BalafiaMaker/CANSAT24_SPACEMCQUEEN/imagenes/vista_ tinkercad_ve.jpg

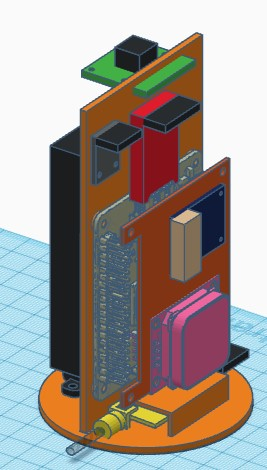
imagenes/vista_ tinkercad_ve.jpg
