BalafiaMaker/CANSAT24_SPACEMCQUEEN/README.md

# CANSAT24_SPACEMCQUEEN
Material per poder construir el CanSat
🧑‍🏭
Captura_de_pantalla_2024-04-27_164813-removebg-preview
