BalafiaMaker/CANSAT24_SPACEMCQUEEN/carcasa/V3_SMcQueen_cansat interior.stl

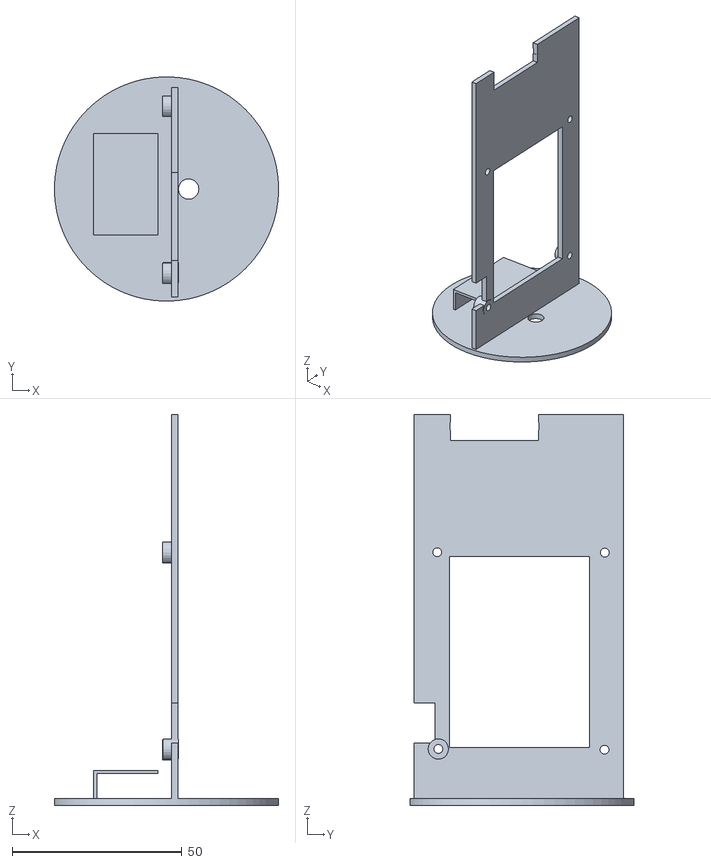
[picture p32: CAD file, 2024-04-27]
carcasa/V3_SMcQueen_cansat interior.stl
66.0 x 66.0 x 115.1
