BalafiaMaker/CANSAT24_SPACEMCQUEEN/carcasa/v3_SMcQueen_cansat exteriorA.stl

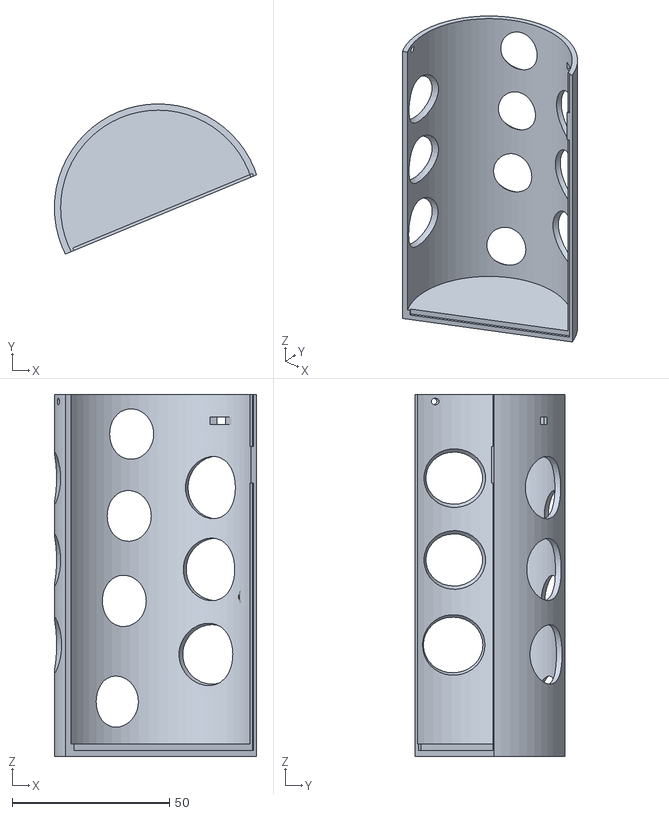
[picture p33: CAD file, 2024-04-27]
carcasa/v3_SMcQueen_cansat exteriorA.stl
64.3 x 47.7 x 115.0
