BalafiaMaker/CANSAT24_SPACEMCQUEEN/carcasa/v3_SMcQueen_cansat exteriorB.stl

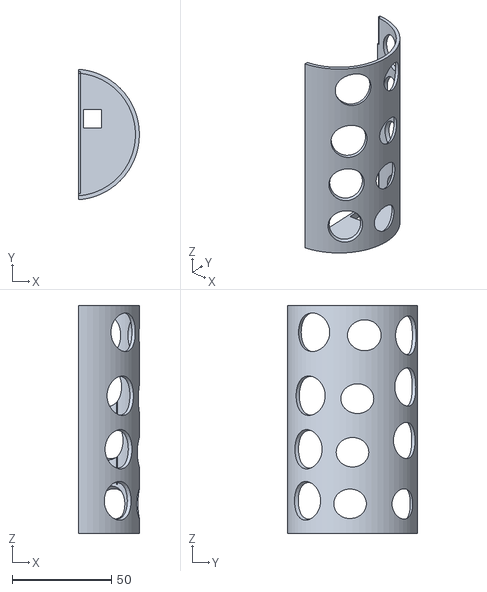
[picture p34: CAD file, 2024-04-27]
carcasa/v3_SMcQueen_cansat exteriorB.stl
30.7 x 65.8 x 115.0
