BalafiaMaker/CANSAT24_SPACEMCQUEEN/carcasa/instrucciones.md

ARCHIVOS STL de la CARCAS SPACEMcQUEEN 
Carpeta donde estan los archivos necesarios para imprimir la carcasa SpaceMcQueen.
